djjoeg/openpilot/hardware/photos/board/board-top.jpg

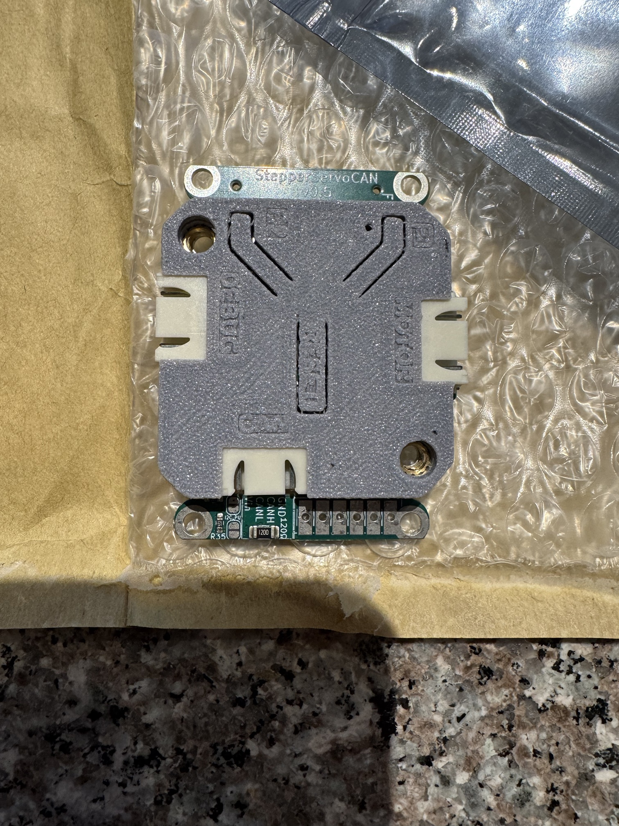
hardware/photos/board/board-top.jpg
