djjoeg/openpilot/hardware/photos/board/board-bottom-labels.jpg

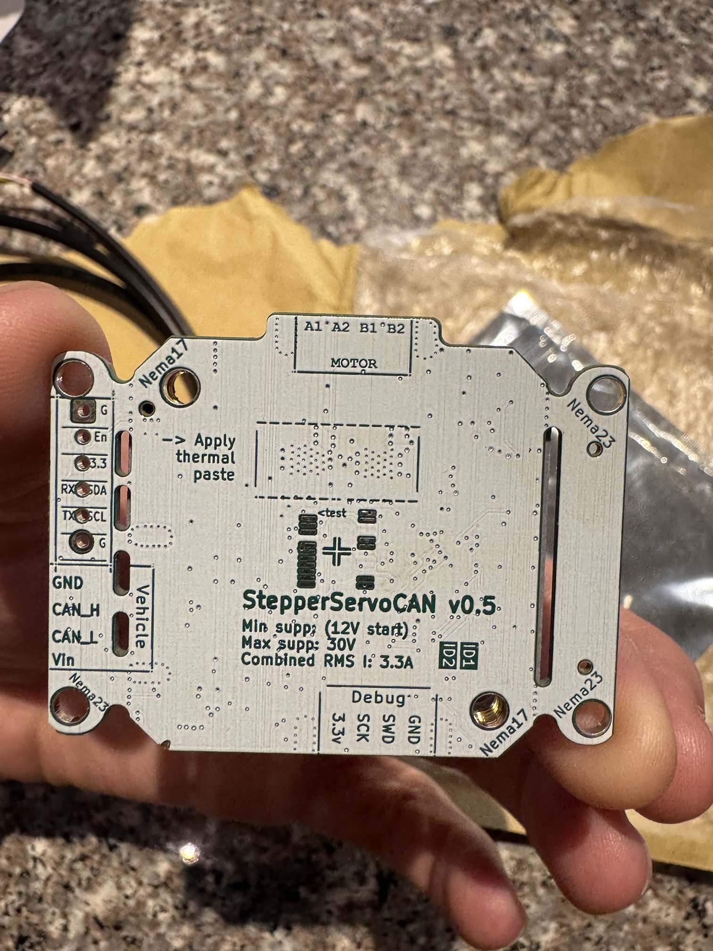
hardware/photos/board/board-bottom-labels.jpg
