djjoeg/openpilot/WHATS-HERE.md

# What's in this backup (7 Nov 2026)

Everything from the project that exists right now, in one place.

- `CHANGELOG.md`: the change log, current (7 Nov).
- `README.md`: the 1.3.0 README as of 3 Nov (step-by-step build; the frame plate part is being redone).
- `hardware/print/`: every print file and paper template made so far (plates 12 to 15, the teeth fit sample,
  the paper templates v1 and v2).
- `hardware/cad/platefit2.py`: the program that draws the paper template v2.
- `hardware/report/`: the design pictures that survived.
- `hardware/wiring/`: the wiring page's source and a picture of it.
- `hardware/motor-card/`: the motor's card, both sides.
- `hardware/photos-marked/`: your photo with the crosspiece spot marked.

Missing: the programs that drew and checked the parts up to 5 Nov (`rightarm.py`, `midteeth.py`,
`rightcheck.py`, `stiffness.py`, `visuals.py`, `plates.py`, `allinone.py`, `platefit.py` and the earlier
mounts' programs). They were only on the workspace that was replaced on 5 Nov. The parts they made are safe:
their print files are in `hardware/print/`.

The software is on GitHub: branch `v1.3.0` (and the earlier versions) of github.com/djjoeg/openpilot and
github.com/djjoeg/opendbc.
