djjoeg/openpilot/hardware/cad/viewer3d_page.html

# Right arm mount v6

2010 Accord, just above 4 o'clock on the steering wheel

Overview Your seat Right side Below

×

Hide this part

Loading the parts…

Together

‹ Back Next ›

ApartTogether

## ShowShow all

Drag to turn. Pinch or scroll to zoom. Two fingers, or right-drag, to move it. Tap a part for its name.

The printed parts are drawn from the same shapes as the print files (plates 9, 11 and 12), where they go on the car. The motor, gear, bolts and nuts are drawn to size. The board on the motor's back is a plain box, and the column cover is approximate.
