djjoeg/openpilot/hardware/print/frame-plate-v3-paper-template-100.pdf

## Frame plate fit test v3: paper template, full size (print at 100%)

Seen from below, as you hold it up under the steering column: printed side down.

TOP EDGE: TOWARD THE STEERING WHEEL

NEW CROSSPIECE: folds up against the cover where it turns up, above the tilt lever's tab

FOLD UP
about 45°

FOLD UP
about 45°

notch: the tab passes under here cup screw

the receiver goes here (do not cut) cut this out: the tilt lever's room

second screw: anywhere in this slot

BOTTOM EDGE: TOWARD THE DASH

DRIVER'S DOOR SIDE

KEY SIDE

0 | 10 | 20 | 30 | 40 | 50 | 60 | 70 | 80 | 90 | 100

100 mm across: it must measure exactly 100 mm

0 | 1 | 2 | 3 | 4

4 in across: it must measure exactly 4 in

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
100 mm up and down: it must measure exactly 100 mm

1. Print at 100% (actual size, not fit to page).
2. Before cutting, measure the three bars. Each must be exactly 100 mm or 4 in. If not, tell me what they measure.
3. Cut on the solid line, notch included, and cut out both slots.
4. Fold the grey strip up along the two short dashed lines, about 45°, away from the printed side.
5. Hold it up under the column, printed side down, top edge toward the wheel: the cup screw in the short slot,
the second screw in the long one. Press the strip up against the cover where it turns up, over the tab.
6. Check: the folds sit where the cover turns up; the tab passes under the notch; the tilt lever goes all the way down and back up; the wheel turns lock to lock. Nothing should touch the paper.
7. Where something doesn't fit, cut the paper until it does and tell me how much you took off. If the folds aren't where the cover turns up, measure how far off they are, toward the wheel or toward the dash.
