djjoeg/openpilot/hardware/motor-card/motor-card-drawing.jpg

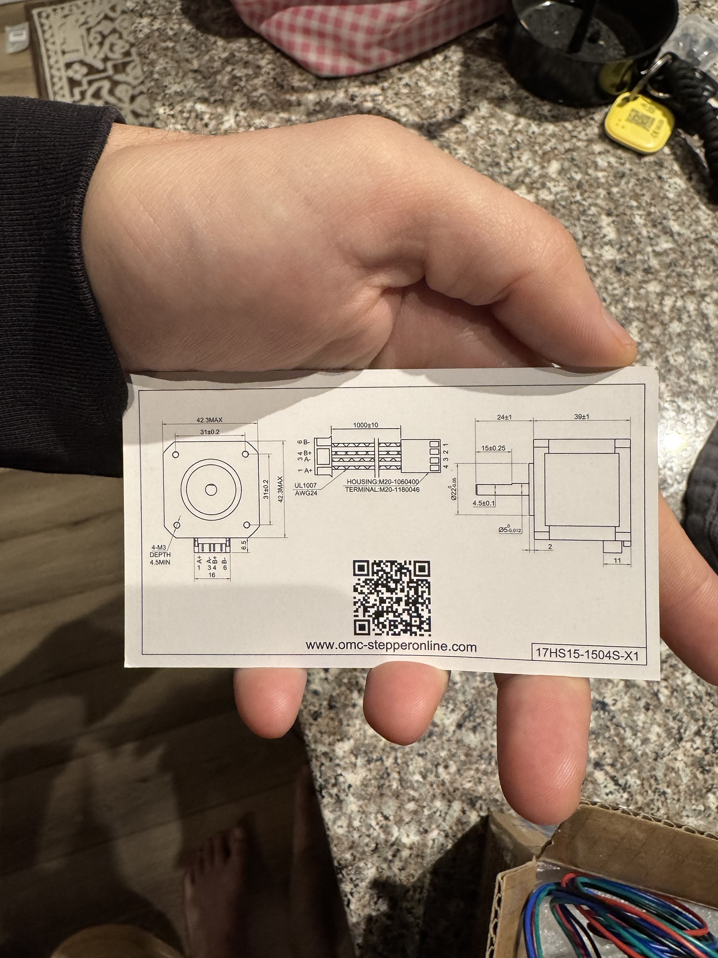
hardware/motor-card/motor-card-drawing.jpg
