djjoeg/openpilot/hardware/motor-card/motor-card-specs.jpg

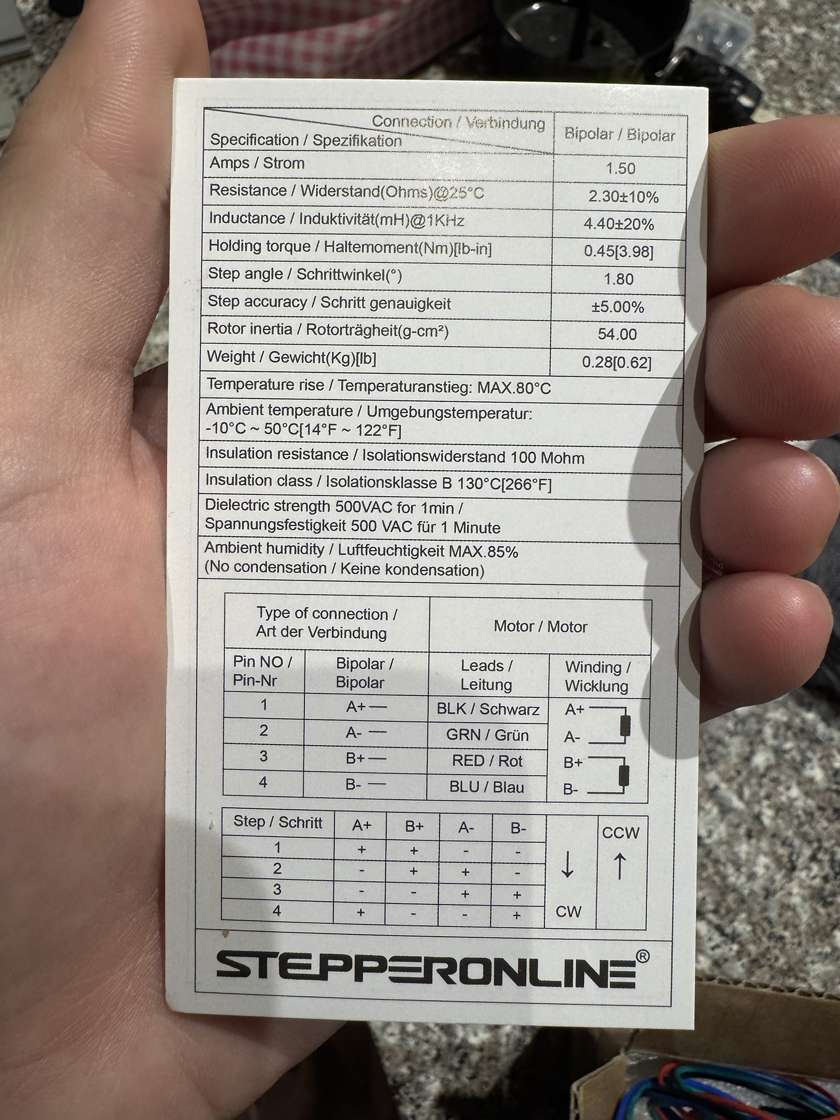
hardware/motor-card/motor-card-specs.jpg
