djjoeg/openpilot/hardware/photos-marked/crosspiece-reading.jpg

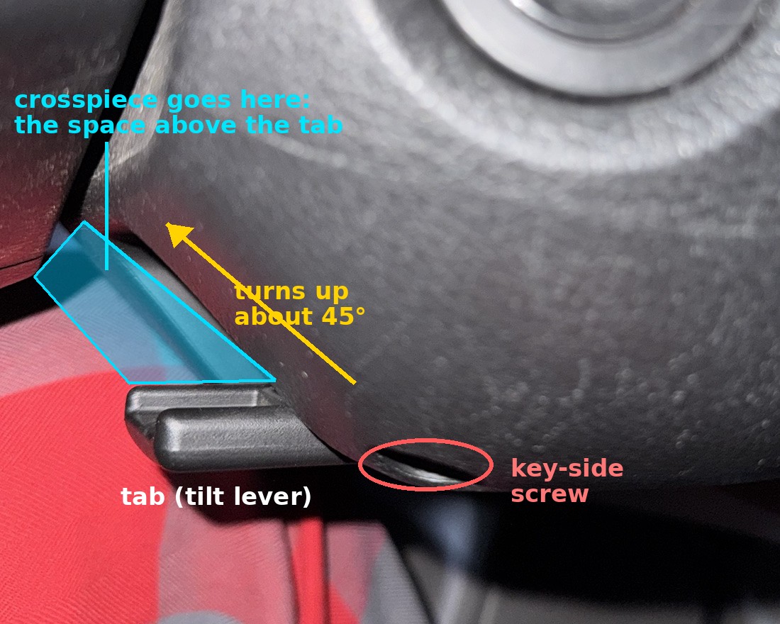
hardware/photos-marked/crosspiece-reading.jpg
