djjoeg/openpilot/hardware/report/arm-v4-v5-below.png

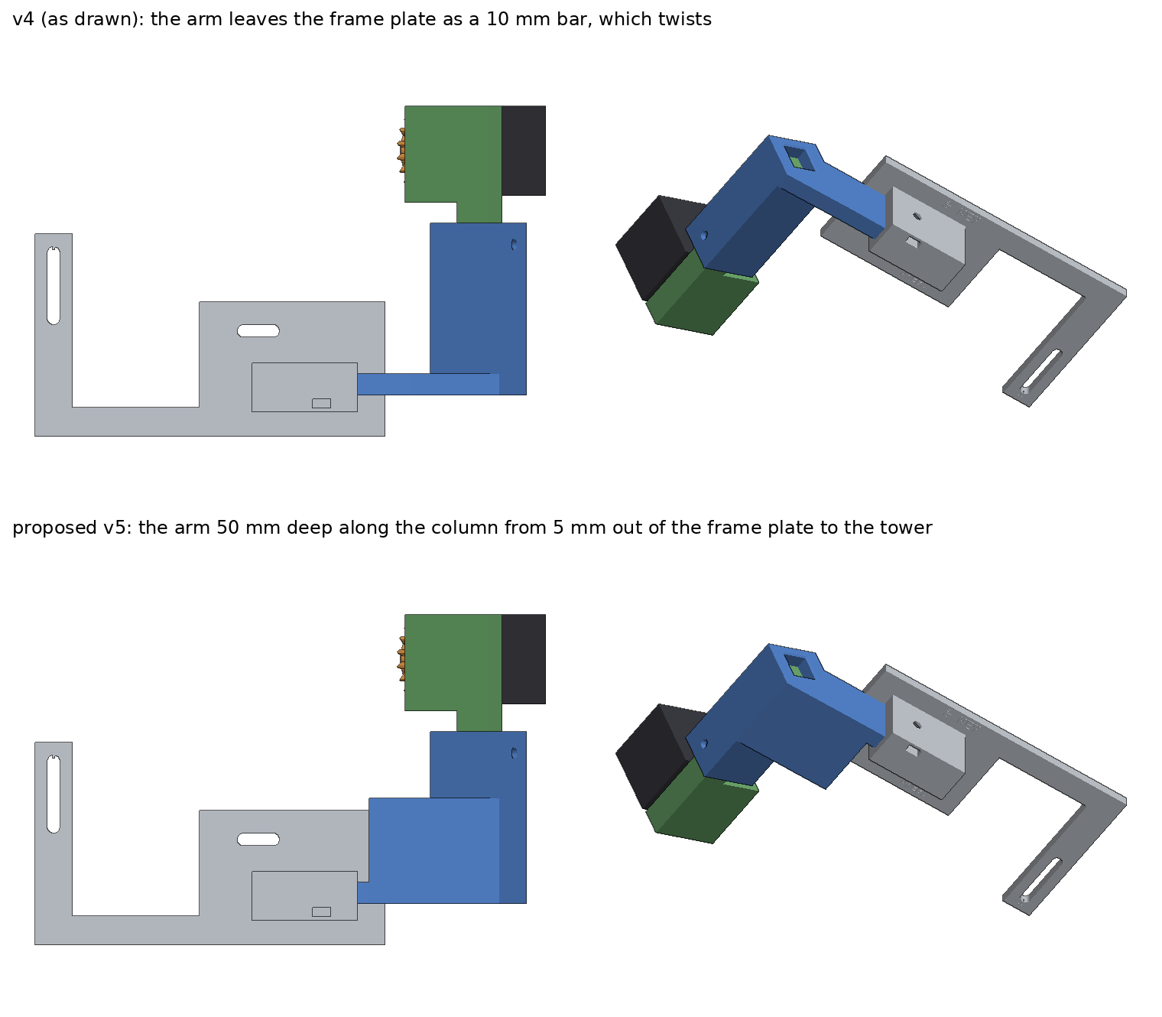
hardware/report/arm-v4-v5-below.png
