djjoeg/openpilot/hardware/report/frame-plate-v3-options.png

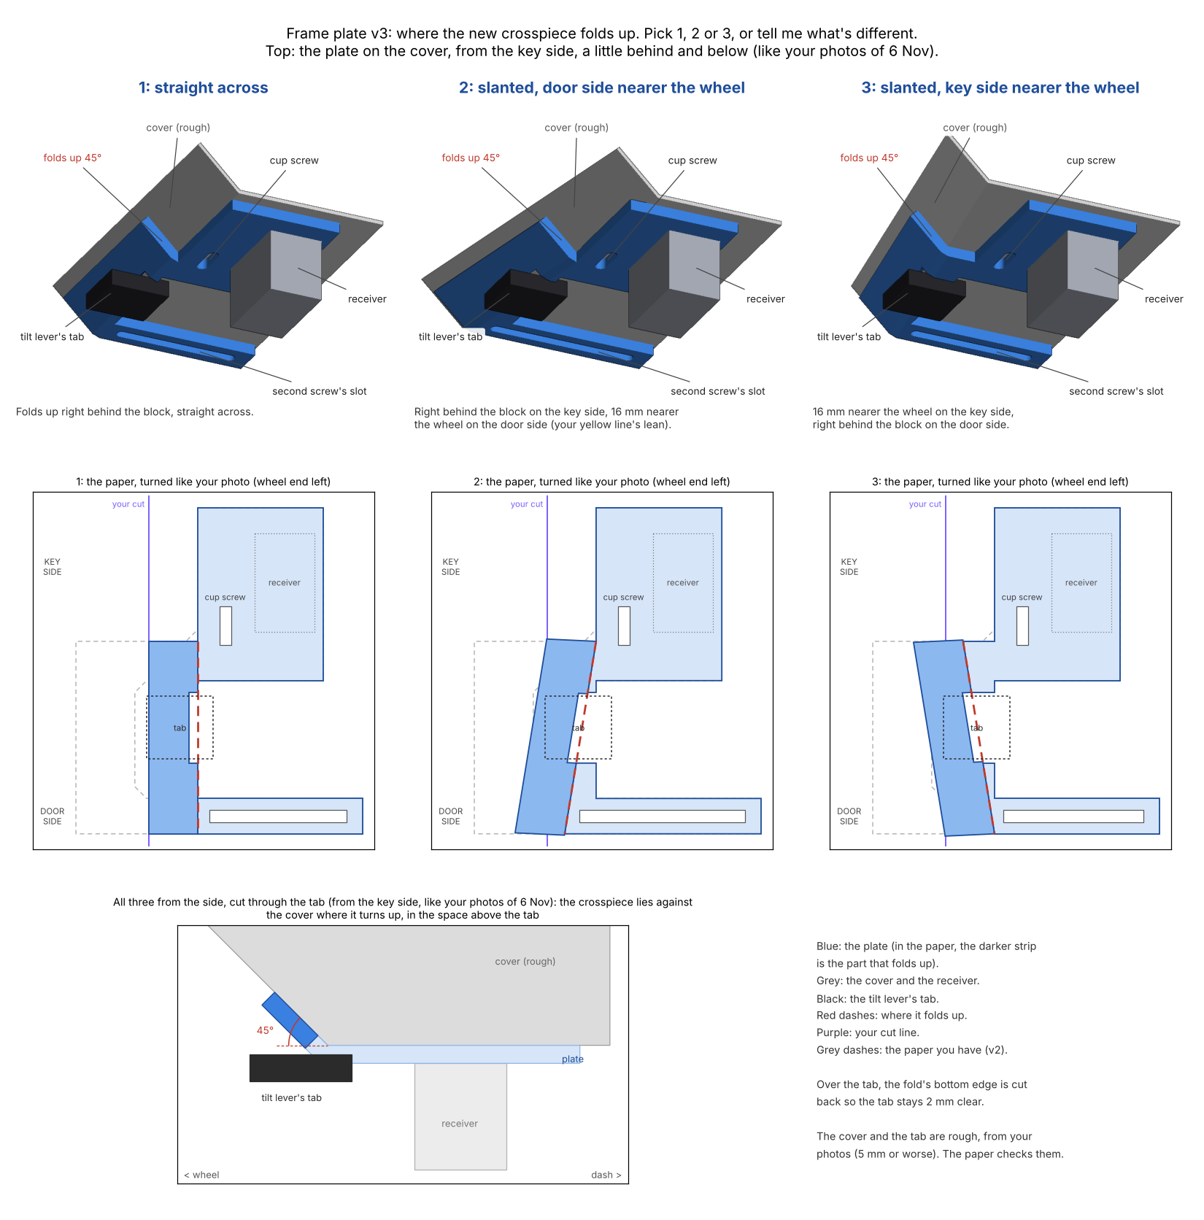
hardware/report/frame-plate-v3-options.png
