djjoeg/openpilot/hardware/report/in-the-car-photo-00-before-after.jpg

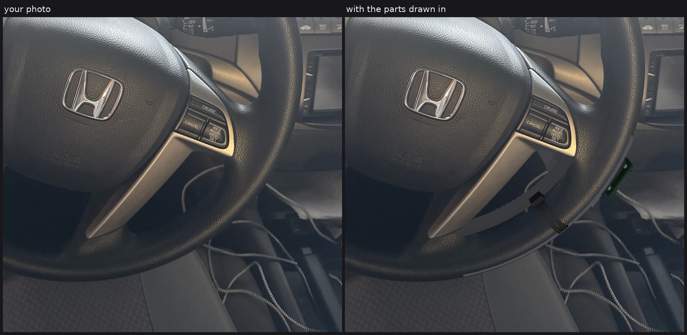
hardware/report/in-the-car-photo-00-before-after.jpg
