djjoeg/openpilot/hardware/report/in-the-car-photo-00.jpg

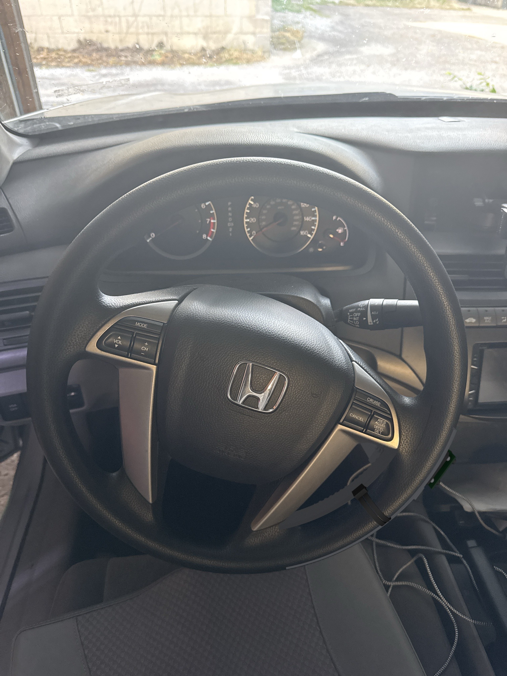
hardware/report/in-the-car-photo-00.jpg
