djjoeg/openpilot/hardware/report/in-the-car-photo-33-before-after.jpg

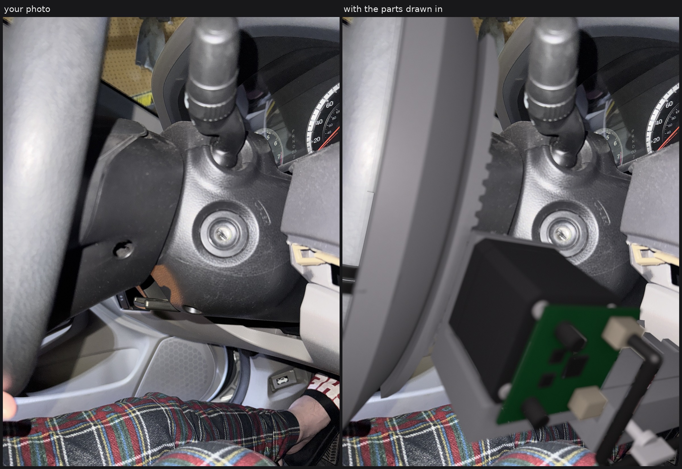
hardware/report/in-the-car-photo-33-before-after.jpg
