djjoeg/openpilot/hardware/report/plate-13-all-in-one.png

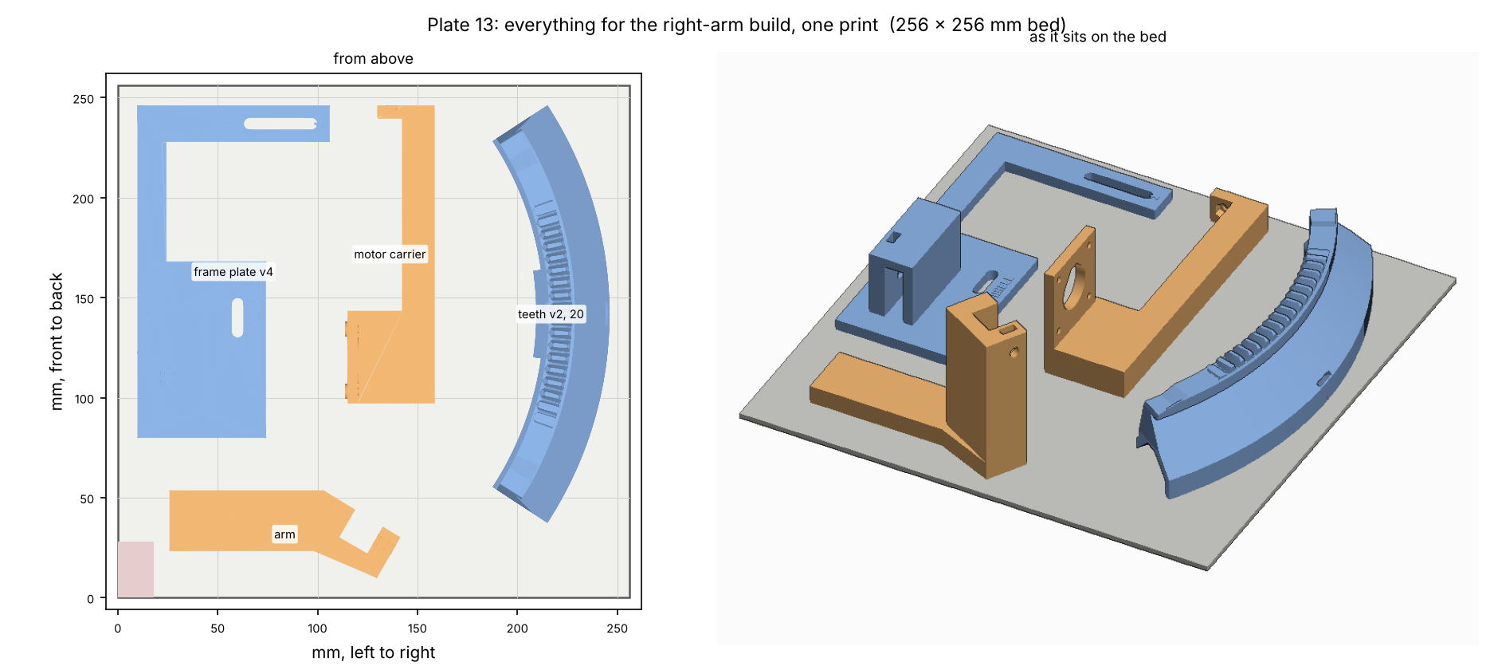
hardware/report/plate-13-all-in-one.png
