djjoeg/openpilot/hardware/report/review-1c-receiver.png

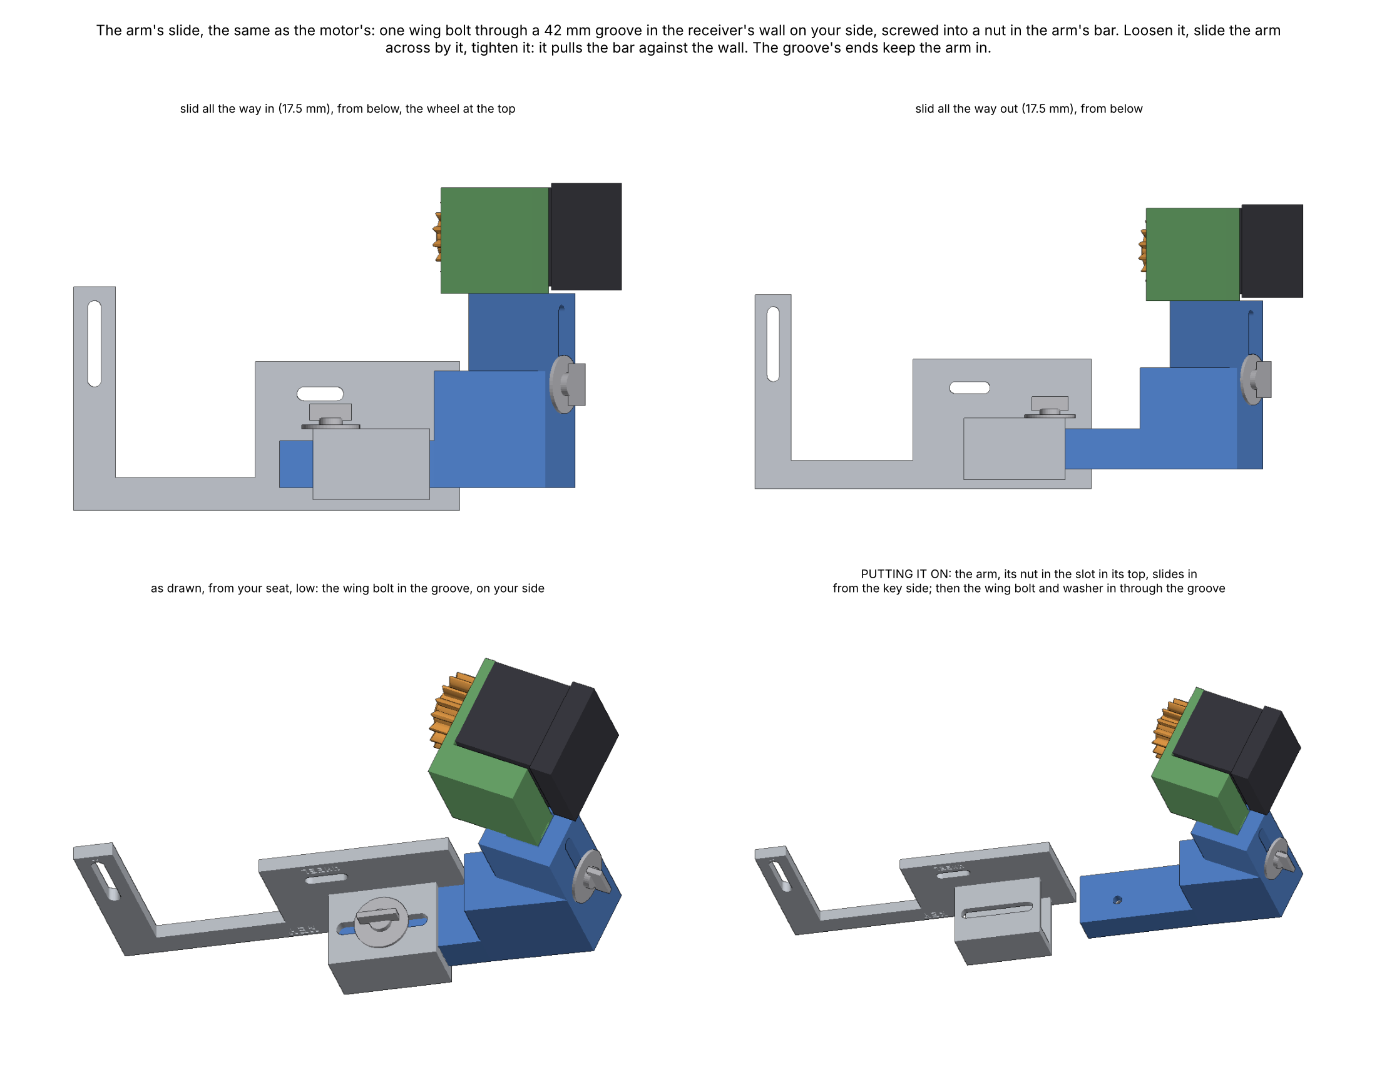
hardware/report/review-1c-receiver.png
