djjoeg/openpilot/hardware/print/plate-13b-all-but-the-frame-plate.3mf

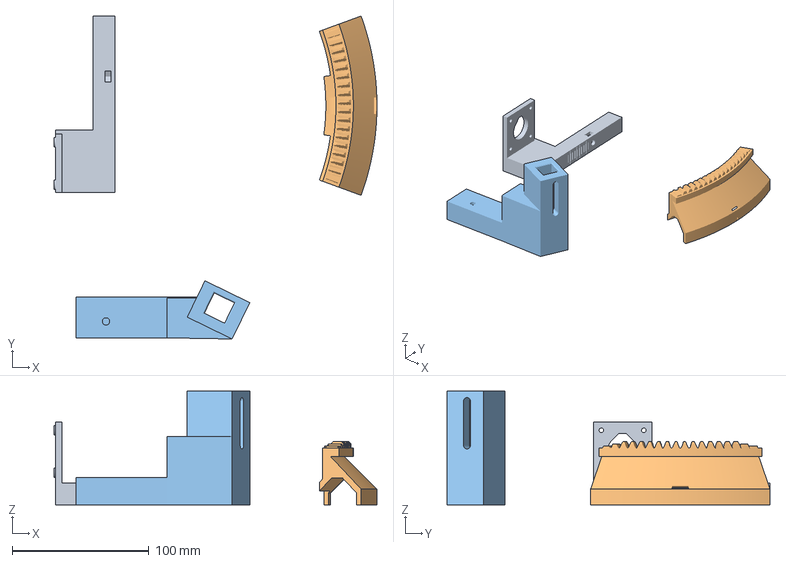
[picture p13: CAD file, 2026-11-07]
hardware/print/plate-13b-all-but-the-frame-plate.3mf
236.0 x 236.0 x 83.2 mm
right-carrier
steering-wheel-teeth-v3-20-winding-roads
right-arm
