djjoeg/openpilot/hardware/print/plate-12-right-arm.3mf

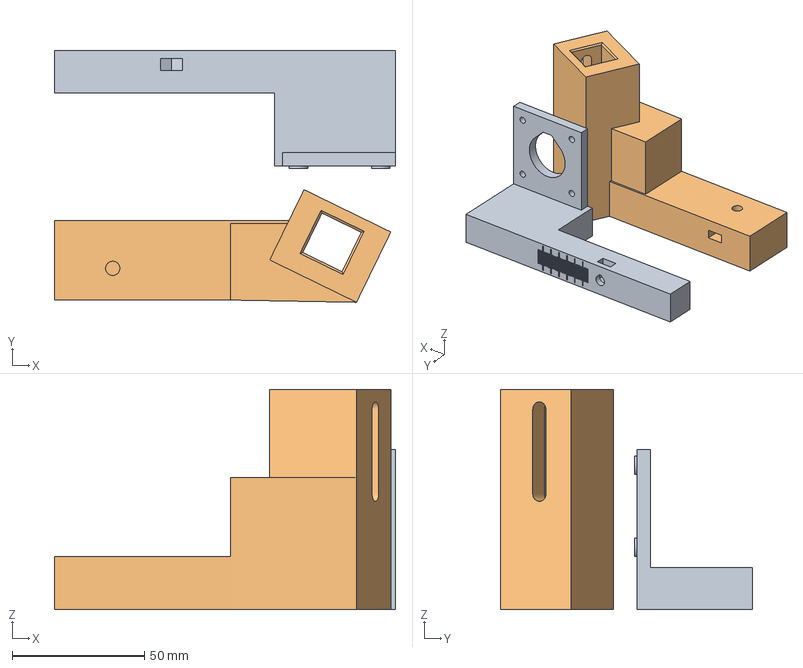
[picture p14: CAD file, 2026-11-07]
hardware/print/plate-12-right-arm.3mf
128.9 x 95.1 x 83.2 mm
right-carrier
right-arm
