djjoeg/openpilot/hardware/print/plate-15-frame-plate-fit-test.3mf

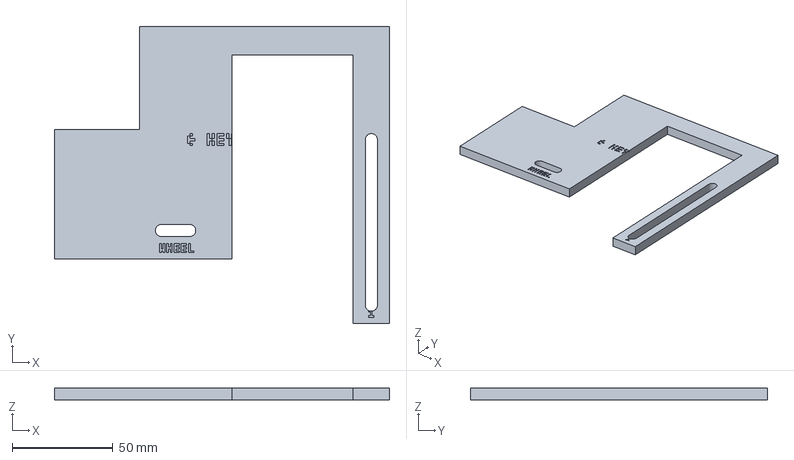
[picture p15: CAD file, 2026-11-07]
hardware/print/plate-15-frame-plate-fit-test.3mf
166.0 x 147.0 x 6.00 mm
