djjoeg/openpilot/hardware/print/plate-13-all-in-one.3mf

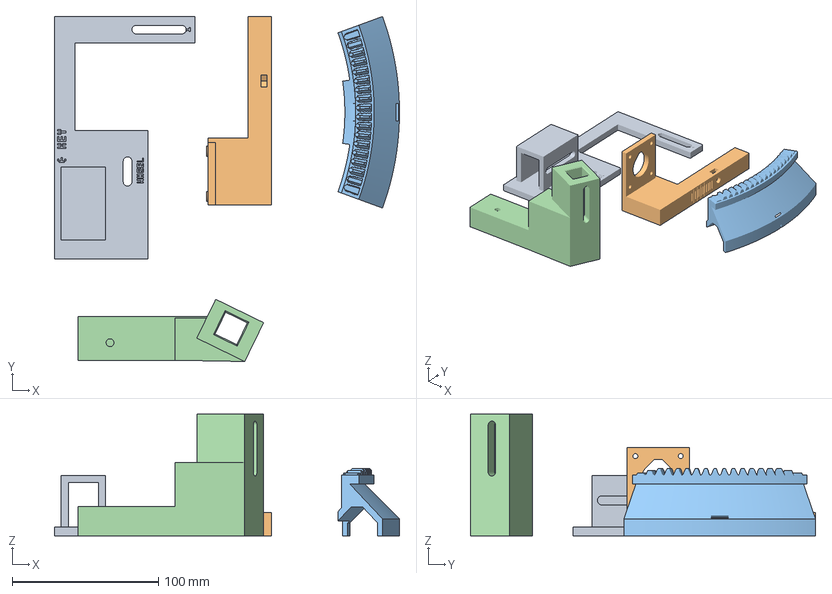
[picture p16: CAD file, 2026-11-07]
hardware/print/plate-13-all-in-one.3mf
236.0 x 236.0 x 83.2 mm
column-frame-plate-v5
right-carrier
steering-wheel-teeth-v3-20-winding-roads
right-arm
