djjoeg/openpilot/hardware/print/plate-14-teeth-fit-sample.3mf

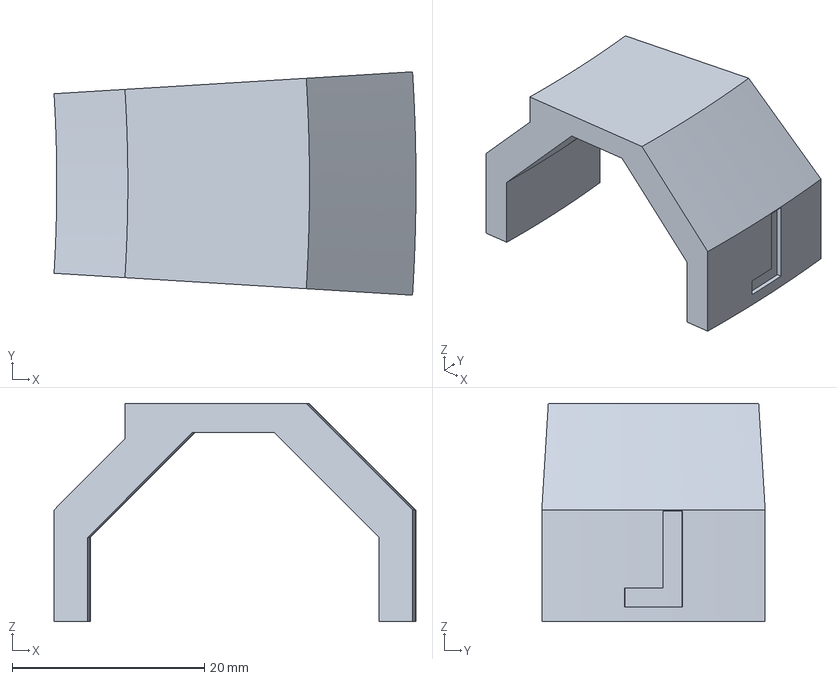
[picture p17: CAD file, 2026-11-07]
hardware/print/plate-14-teeth-fit-sample.3mf
37.7 x 23.3 x 22.7 mm
