djjoeg/openpilot/hardware/wiring/wiring-page-source.dc.html

comma four
top middle of the windshield

comma harness
its box: under the dash, right of the column

Not used: tape each bare end on its own: both orange, both green, the 2nd pink and blue. Leave the short grey loop as it is. The harness's wires are only 12 cm (4.7 in): the nuts sit right by its box.

Motor + board
behind the rim at 4 o'clock
board's own 1 m cable

12 V socket plug
in the console's 12 V socket; 15 A fuse inside

+ lever nut

− lever nut

Wiring: Accord lane keeping

Laid out as you see it from the driver's seat. Each colored line is one wire; it ends in a lever nut or a board.

software 1.3.0 · 10 Nov 2026

WINDSHIELD

CENTER CONSOLE

STEERING WHEEL
from your seat

long OBD-C cable

pink ↔ yellow
blue ↔ white
CAN: inline nuts

2 red

2 brown

2 black

pairs twisted,
one hole each

red, Vin

black, GND

+ lead

− lead

CHECK FIRST, WITH THE MULTIMETER

1. Motor cable in the motor, at its 4-pin end (Ω): pins 1–2 and 3–4 read 2–3 Ω each; 1–3 reads nothing.

2. Plug and harness in the nuts, plug out (Ω): + nut to − nut must not read 0.

3. Plug in, key to ACC (V DC, red probe on +): about 12 V, no minus sign. Key off, plug out.

4. Board in, no power (Ω): + to − still not 0; pink to blue about 120 Ω (the board's own).

FIRST POWER-UP

5. Motor gear out of the teeth. Plug in, key on: the board may turn the motor slowly to set itself up. If its blue light stays on, press F1. Then plug in the comma four.

GOOD TO KNOW

The board's 1 m cable reaches the nuts: cut off its far plug, strip 11 mm. No extra resistor, on purpose. The only fuse is the plug's 15 A (socket 10 A; this draws under 4 A). Board stays dark? Red and black are swapped: swap them back (it's protected).
