djjoeg/openpilot/hardware/print/frame-plate-fit-test-template-your-printer.pdf

TOP EDGE: TOWARD THE STEERING WHEEL

DRIVER'S DOOR SIDE

KEY SIDE

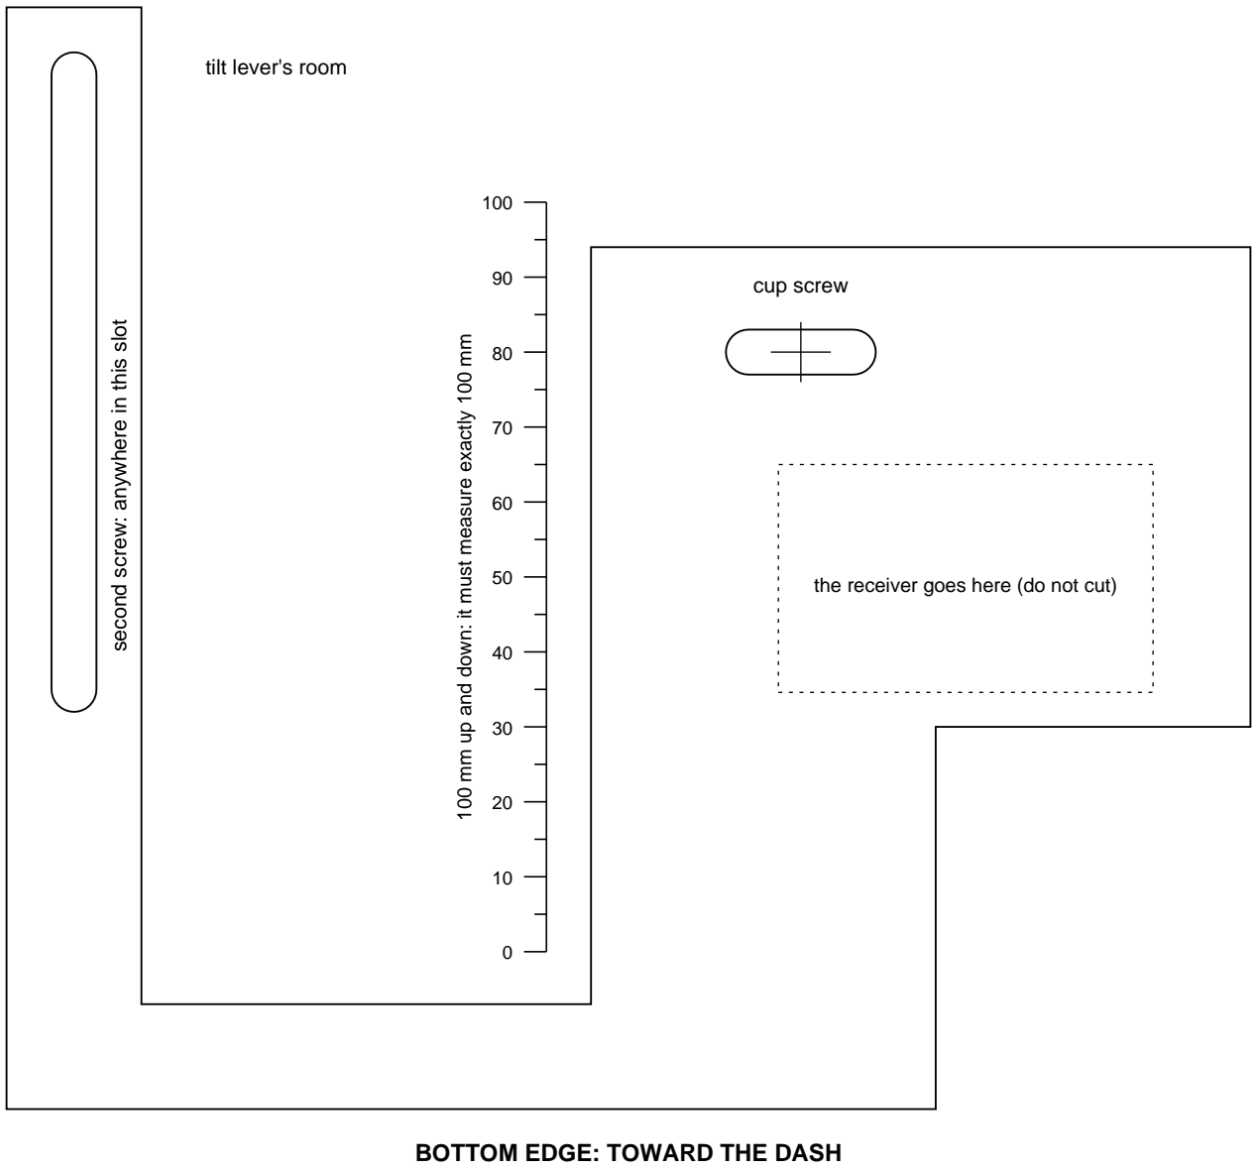
[picture p18: figure]
cup screw; the receiver goes here (do not cut); second screw: anywhere in this slot; tilt lever's room; BOTTOM EDGE: TOWARD THE DASH

0 | 10 | 20 | 30 | 40 | 50 | 60 | 70 | 80 | 90 | 100
100 mm across: it must measure exactly 100 mm
0 | 1 | 2 | 3 | 4
4 in across: it must measure exactly 4 in

100 mm up and down: it must measure exactly 100 mm

## Frame plate fit test (plate 15): paper template, scaled for your printer

Seen from below, as you hold it up under the steering column: printed side down.

1. For your printer, which prints a page at 93.75% (your 4 in bar came out 3.75 in): drawn 6.7% bigger, so it comes out full size. Print it exactly the way you did before.
2. Measure all three bars: each must now be exactly 100 mm or 4 in. If not, tell me what they measure.
3. Cut along the solid lines, the two slots too. Card stock holds its shape better than paper.
4. Hold it up under the column, printed side down, the top edge toward the steering wheel: the cup screw in the short slot, the second screw in the long one. Work the tilt lever all the way down and back up.
