djjoeg/openpilot/hardware/print/frame-plate-v2-paper-template-your-printer.pdf

## Frame plate fit test v2: paper template, scaled for your printer

Seen from below, as you hold it up under the steering column: printed side down.
TOP EDGE: TOWARD THE STEERING WHEEL

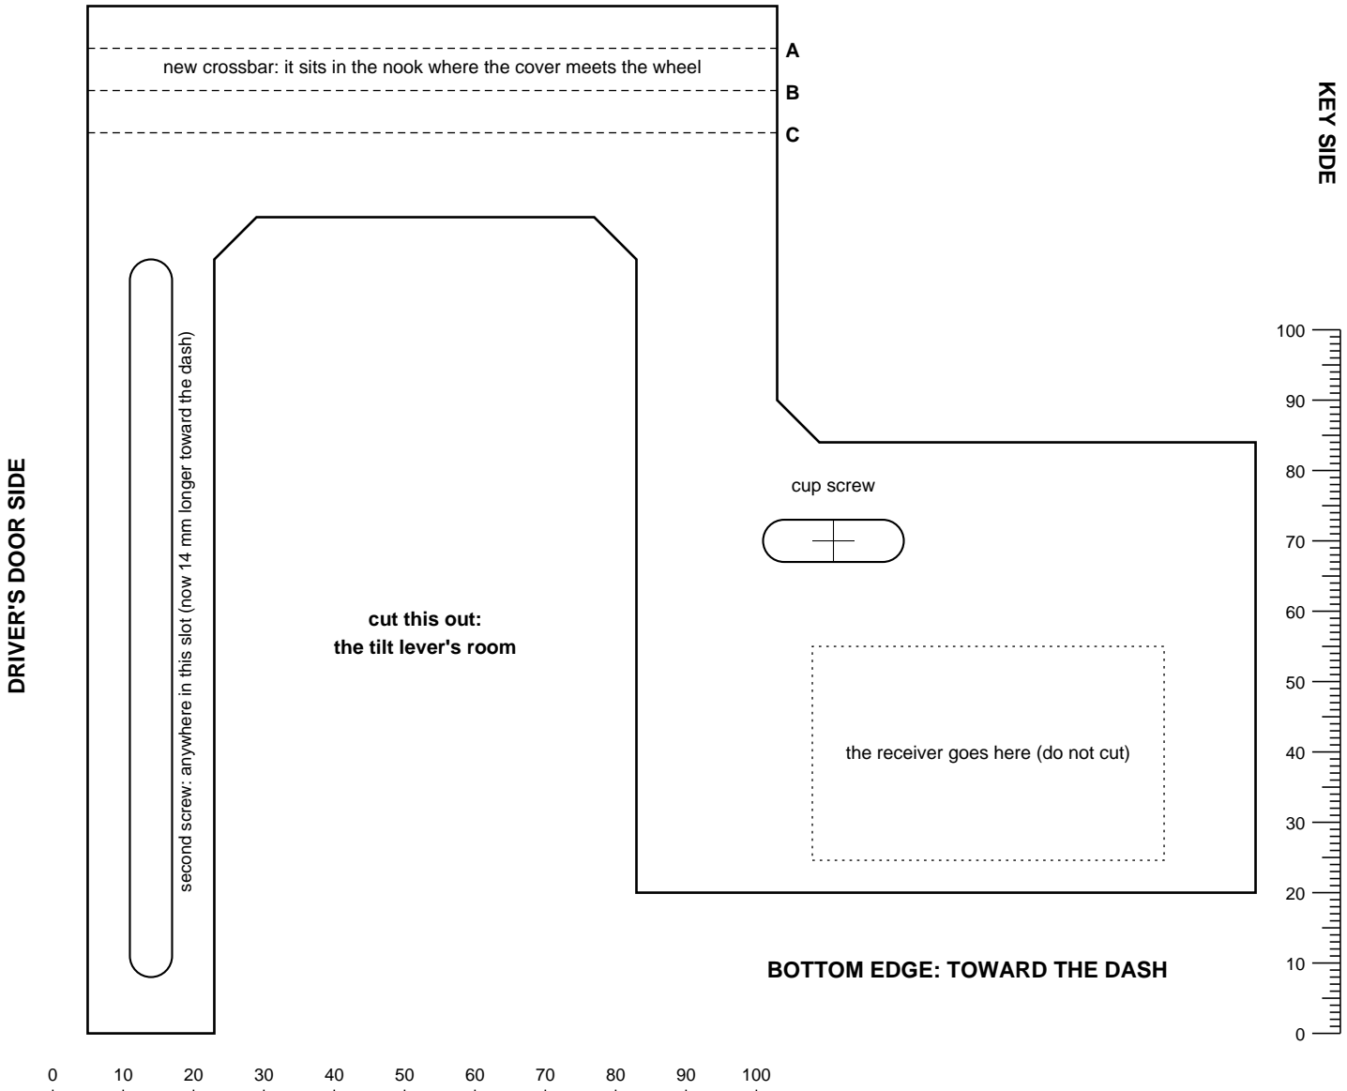
[picture p19: figure]
cup screw; the receiver goes here (do not cut); cut this out: the tilt lever's room; BOTTOM EDGE: TOWARD THE DASH; DRIVER'S DOOR SIDE; KEY SIDE

new crossbar: it sits in the nook where the cover meets the wheel

second screw: anywhere in this slot (now 14 mm longer toward the dash)

100 mm across: it must measure exactly 100 mm

0 | 1 | 2 | 3 | 4

4 in across: it must measure exactly 4 in

100 mm up and down: it must measure exactly 100 mm

1. Print it exactly the way you printed the first one. It is drawn 5.8% big, because your printer shrinks a
page to 94.5% (the first one's 4 in bar came out 4 1/32 in), so it should come out full size.
2. Before cutting, measure the three bars. Each must be exactly 100 mm or 4 in. If not, tell me what they measure.
3. Cut on the solid line, and cut out both slots. The middle is open: that is the tilt lever's room.
4. Hold it up under the column, printed side down, top edge toward the wheel: the cup screw in the short
slot, the second screw in the long one.
5. Check three things: the tilt lever goes all the way down and back up without touching the paper; the wheel turns lock to lock without touching it; the crossbar sits in the nook.
6. If the crossbar's top edge touches anything, cut it back to line A, B or C, and tell me which line.
C is as narrow as the crossbar can be.
