djjoeg/openpilot/hardware/print/frame-plate-v2-before-after.png

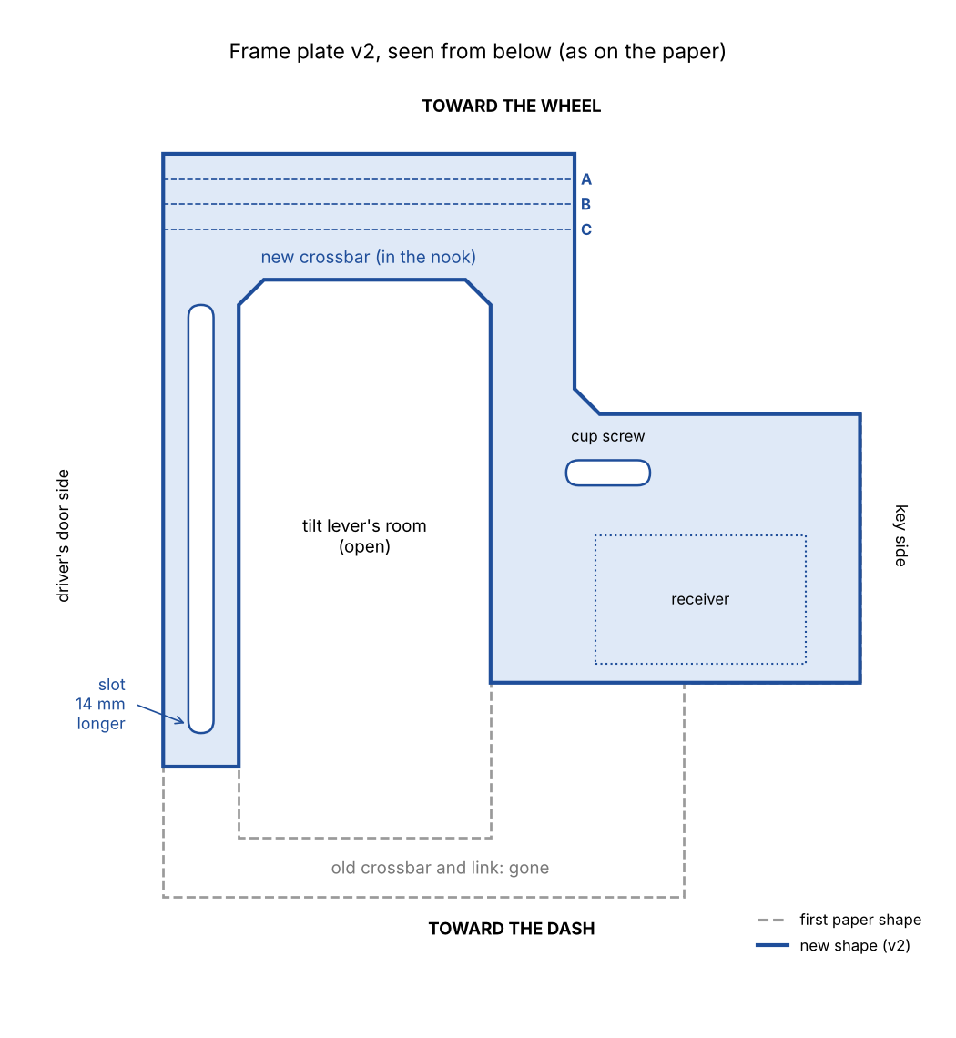
hardware/print/frame-plate-v2-before-after.png
