djjoeg/openpilot/hardware/wiring/wiring-page.png

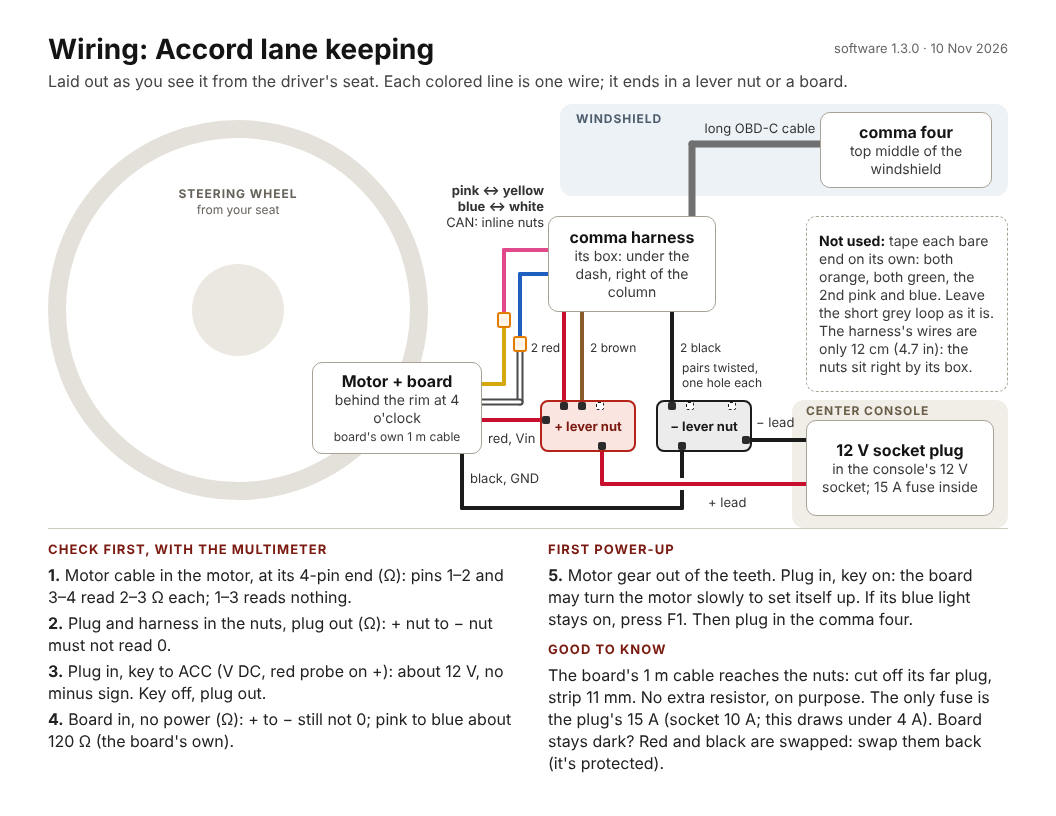
hardware/wiring/wiring-page.png
