djjoeg/openpilot/hardware/print/frame-plate-fit-test-template.pdf

TOP EDGE: TOWARD THE STEERING WHEEL

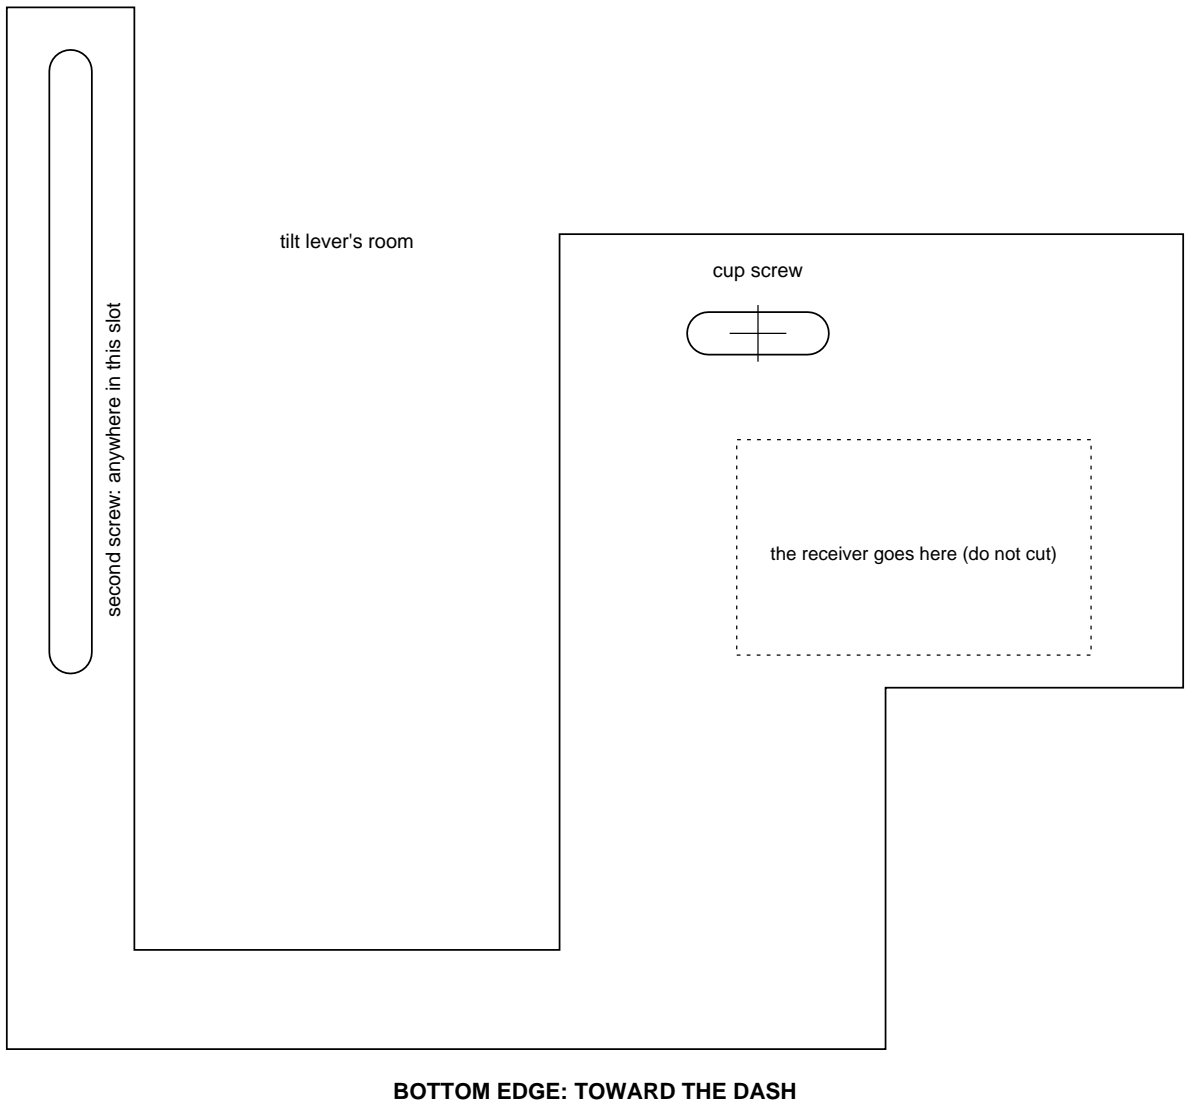
[picture p22: figure]
cup screw; the receiver goes here (do not cut); second screw: anywhere in this slot; tilt lever's room; BOTTOM EDGE: TOWARD THE DASH

DRIVER'S DOOR SIDE

KEY SIDE

## Frame plate fit test (plate 15): full-size paper template

Seen from below, as you hold it up under the steering column: printed side down.

0 | 10 | 20 | 30 | 40 | 50 | 60 | 70 | 80 | 90 | 100
100 mm: measure it; it must be exactly 100 mm
0 | 1 | 2 | 3 | 4
4 in: measure it; it must be exactly 4 in
1. Print at 100% ("Actual size"), not "Fit to page". Measure both bars above: if either is off, the
printer scaled it; print again.
2. Cut along the solid lines, the two slots too. Card stock holds its shape better than paper.
3. Hold it up under the column, printed side down, the top edge toward the steering wheel: the cup screw in the short slot, the second screw in the long one. Then work the tilt lever all the way down and back up.
