djjoeg/openpilot/hardware/report/frame-plate-fit-test.png

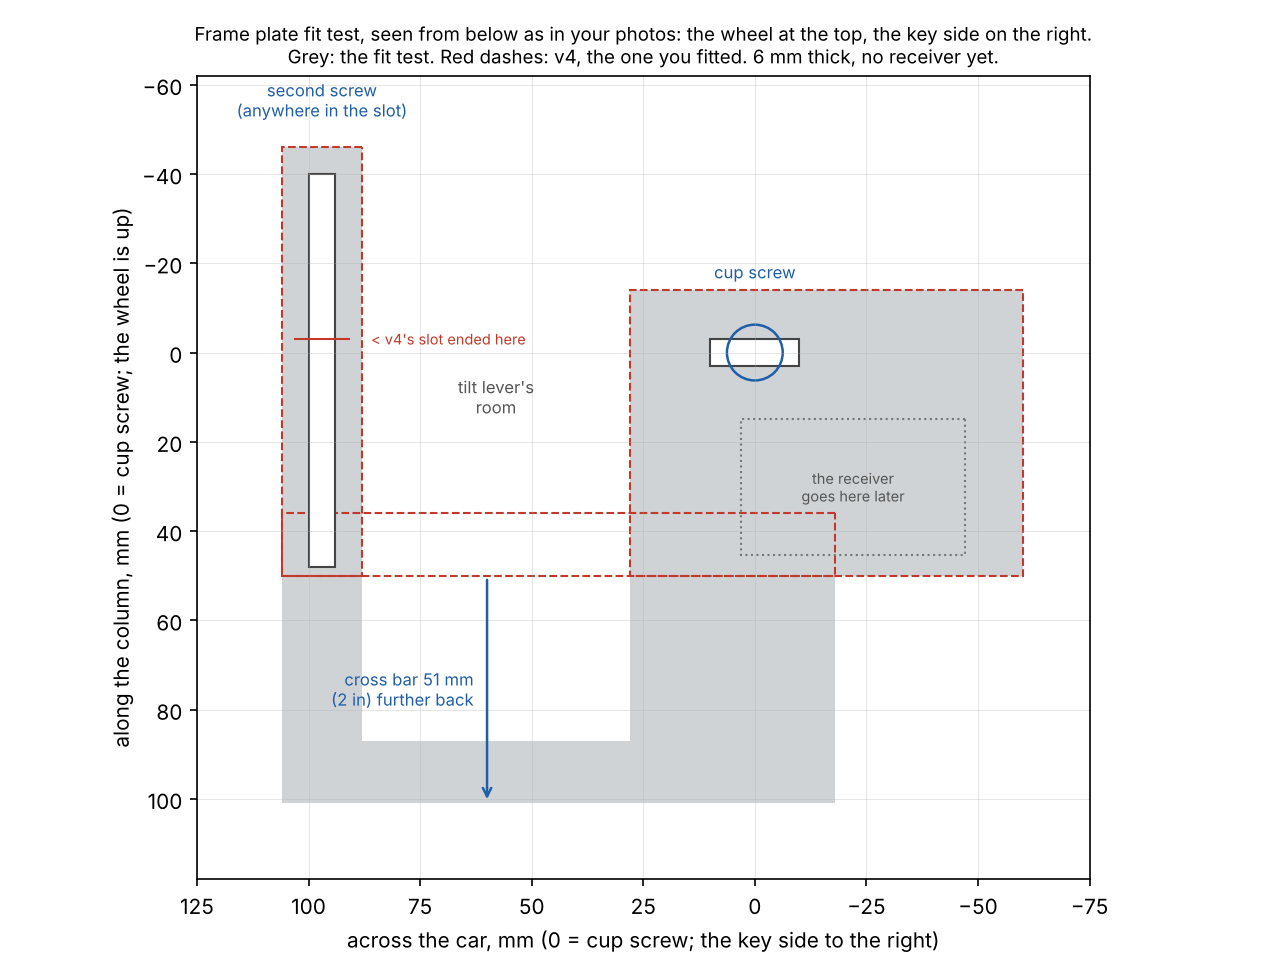
hardware/report/frame-plate-fit-test.png
