djjoeg/openpilot/hardware/cad/columnparts.py

"""
The column mount's own parts. The motor sits under the steering wheel, behind it, with its gear inside a ring of
teeth that faces the hub; the ring stands back from the bottom of the steering wheel on a skirt. The arm goes up to
a two-piece clamp round the steering column covers. Everything else (motor gear, motor carrier, lever bracket, lift
lever, hinge block, spring, arm, setup gauge) is the dash mount's part, unchanged.

  ring teeth     - zip-tied round the bottom of the steering wheel (5 to 7 o'clock) like the steering wheel teeth, but
                   with no teeth on the outside: a ring at the front face joins a skirt that stands back behind the
                   wheel, and the skirt's inside carries the rolling band and the teeth, facing the hub. The short
                   set only (16 teeth): the long set doesn't fit between the wheel's two lower spokes.
  column clamp   - two V-shaped saddles, one over the steering column covers and one under them, pulled together by
                   four M6 threaded rods beside the covers. The lower saddle carries the arm's angle joint (the same
                   joint as the dash clamp's). Rubber strips on the V faces grip the covers.
  fit test       - a few ring teeth with their rolling band, to try the printed motor gear in by hand.

Frames: the steering wheel frame (z along the steering column towards the driver, +y 12 o'clock, +x the driver's
right; the part of the wheel you hold is centred on z = 0). The clamp parts are drawn in the clamp frame: origin on
the column's axis at the middle of the clamp, +y up (towards 12 o'clock), +z towards the driver.
"""
import math

import numpy as np
from manifold3d import CrossSection, Manifold

import gears as GR
import mountparts as MP
import wheelparts as WP
from cadlib import box, circle_yz, clean, cyl, cyl_x, cyl_y, extrude_x, polar_mask, rect_yz, revolve, sector, union
from params import (ARM_T, ARM_W, BACKLASH, CD_EXTRA, COVER_H, COVER_H_RANGE, COVER_W_RANGE, END_CHAMFER, END_LEAD_IN, FRONT_RING_T,
                    M5_CLEAR, M6_CLEAR, M6_NUT_AF, MOTOR_TEETH, RING_TEETH, ROLLER_R, SKIRT_T, Z_GEAR_ROLLER, Z_GEAR_TEETH,
                    Z_MOTOR_FACE, Z_MOTOR_FACE_C)

GAP = MP.GAP


def centre_distance() -> float:
  """Steering column to the motor's axis with the motor gear inside the ring teeth."""
  return GR.pitch_radius(RING_TEETH) - GR.pitch_radius(MOTOR_TEETH) - CD_EXTRA


# the motor gear's roller and teeth along the column, in the steering wheel frame, with the motor's face at Z_MOTOR_FACE_C
Z_GEAR_ROLLER_C = tuple(z - Z_MOTOR_FACE + Z_MOTOR_FACE_C for z in Z_GEAR_ROLLER)
Z_GEAR_TEETH_C = tuple(z - Z_MOTOR_FACE + Z_MOTOR_FACE_C for z in Z_GEAR_TEETH)
Z_TEETH_C = (Z_GEAR_TEETH_C[0] + 0.2, Z_GEAR_TEETH_C[1] + 0.5)      # the ring's teeth: clear of the roller, past the gear's tips
RING_BACK_Z = Z_GEAR_ROLLER_C[0] + 3.0     # the skirt's back face: the roller's back 3 mm hang off the rolling band, so
                                           # the carrier's plate (1 mm behind the roller) clears the back face as it lifts
Z_ROLL_C = (RING_BACK_Z, Z_TEETH_C[0])     # the rolling band, behind the teeth
# Dropping (the carrier turned DROP_DEG about its hinge, the roller off the rolling band), the motor gear's teeth also
# move about 3.2 mm back along the column into the rolling band's zone; from here forward the ring's inside follows
# the lead-in at the teeth root's distance, so those teeth clear it
Z_TEETH_SPLIT = Z_GEAR_TEETH_C[0] - 3.4
GUARD_WINDOW_C = 64.0                       # the column mount's carrier: finger guard open this far either side of down


SHALLOW_REACH = 8.0           # a shallow channel's walls reach only this far in from the middle of the grip, so the
                              # piece can sit over a spoke's junction with the grip (the right-side ring)
SLOT_EVERY_DEG = 4.5          # zip tie slots all along the piece, this far apart: tie it where the spokes allow


class RingTeeth:
  """Radii and angles of the ring teeth (the short set) for one steering wheel size. shallow: the channel's walls
  reach only SHALLOW_REACH in from the middle of the grip instead of wrapping it to its middle."""

  def __init__(self, wheel_od: float, grip: float, shallow: bool = False):
    self.base = WP.Teeth(wheel_od, grip, 15)        # the channel round the grip and the zip ties: the short set's
    b = self.base
    self.shallow = shallow
    self.front_inner = b.rr + SHALLOW_REACH if shallow else b.front_inner
    self.back_inner = b.rr + SHALLOW_REACH + 1.0 if shallow else b.back_inner
    self.z_slope_top = b.r_in - (self.back_inner + b.wz_out)   # the 45 degree back slope meets the outer band here
    self.n_teeth = b.n_teeth
    self.tie_angles = b.tie_angles
    self.rp = GR.pitch_radius(RING_TEETH)
    self.r_tip = self.rp - GR.ADDENDUM * GR.MODULE         # the ring's teeth point inwards
    self.r_root = self.rp + GR.DEDENDUM * GR.MODULE
    self.r_roll = centre_distance() + ROLLER_R             # the rolling band's inside, where the motor gear's roller rides
    self.r_skirt_in = self.r_root                          # the skirt's inside face
    self.r_out = self.r_root + SKIRT_T
    self.pitch_deg = b.pitch_deg
    self.teeth_half = b.teeth_half
    self.roll_half = b.roll_half
    self.chamfer_deg = math.degrees(END_CHAMFER / self.r_skirt_in)
    self.teeth_chamfer = self.r_root + 0.6 - self.r_tip      # the teeth's front ends slope back 45 degrees over this
    self.half = self.roll_half + END_LEAD_IN + self.chamfer_deg
    if self.r_skirt_in - b.r_base < 2.0:
      raise ValueError(f"a steering wheel {wheel_od} mm across leaves no room between the band and the ring's skirt")

  @property
  def tracked_arc_deg(self) -> float:
    return 2.0 * self.roll_half

  @property
  def teeth_arc_deg(self) -> float:
    return 2.0 * self.teeth_half

  @property
  def span_deg(self) -> float:
    return 2.0 * self.half
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
