djjoeg/openpilot/(commit log)

2026-11-07 Hardware: design files backup, 7 Nov 2026
    Everything that exists for the Accord lane keeping hardware as of 7 Nov:
    the change log, the 1.3.0 README, every print file and paper template,
    the paper template v2 program, the wiring page, the motor's card and the
    design pictures. WHATS-HERE.md lists it, and what is still being rebuilt.
    Claude-Session: https://claude.ai/code/session_01WuqK7i55vEcsFg9coyXLyu
    [plate-12-right-arm.3mf, plate-13-all-in-one.3mf, plate-13b-all-but-the-frame-plate.3mf, plate-14-teeth-fit-sample.3mf, plate-15-frame-plate-fit-test.3mf]
2026-11-07 Hardware: design programs rebuilt from the chat record
    39 programs plus the 3D page template in hardware/cad, rebuilt by replaying every
    recorded write, edit and command in order (recovery/assemble.py, recovery/ops).
    platefit2.py replays identical to the surviving copy; platefit.py's fit-test
    plate matches plate-15 in size and volume. Not run here (no manifold3d).
    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
    [turns_000_039.tsv, turns_040_079.tsv, turns_080_119.tsv, turns_120_159.tsv, turns_160_199.tsv, turns_200_239.tsv, turns_240_279.tsv, turns_280_319.tsv]
2026-11-07 Hardware: rebuilt programs verified; plates 12 and 13b brought up to v6
    Ran with manifold3d 3.5.4 built from source: plates 13, 14 and 15 identical to
    the user's print files; rightcheck 8391 checks, 0 failed; stiffness numbers as
    in the change log. The user's plates 12 and 13b held a pre-v6 arm; replaced with
    the v6 ones the programs make.
    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
    [plate-12-right-arm.3mf, plate-13b-all-but-the-frame-plate.3mf]
2026-11-09 Hardware: model the StepperServoCAN board at its real size (56 x 43.3)
    Long side along the column hits the arm with the carrier slid 15+ mm down;
    long side around the wheel passes all 8391 checks (case 11 or 16 mm tall).
    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
2026-11-10 Change log: what came with the board; magnet missing; motor cable plan
    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
2026-11-10 Change log: magnet was in the kit; buy a 6-pin to XH 4-pin motor cable
    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
2026-11-10 Change log: Amazon pick for the motor cable and thermal paste
    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
2026-11-10 Change log: re-checked motor cable pick, meter check, magnet under the sticker
    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
2026-11-10 Change log: motor socket is PH 2.0, read from the motor card photo
    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
2026-11-10 Board plugs and motor socket in the CAD; wiring with the board's own cable; README status and steps
    All 8391 checks pass with the motor's plug along the column and the board's
    plugs in. Wiring page v8. README: status, to-do, board onto the motor, bench
    power-up.
    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
2026-11-11 Frame plate v3: three ways for the new crosspiece to fold up, drawn to pick from
    Your marked paper (11 Nov): the old crossbar cut off at the purple line, a new crosspiece right
    behind the block that folds up about 45 degrees with the cover, over the tilt lever's tab.
    Options 1 (straight across), 2 and 3 (slanted either way, 16 mm). Cover and tab rough.
    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
2026-11-11 Frame plate paper template v3 (option 1: straight across, folding up over the tab)
    Your pick of 11 Nov. The crosspiece right behind the block, 25 mm wide laid flat, folds up about
    45 degrees with the cover; notched 4.6 mm over the tilt lever's tab. Scaled for your printer as v2
    (checked: the 100 mm bar is 105.8 mm in the file). Change log and README to-do updated.
    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
